Tinkerforge/isolator-bricklet/hardware/isolator.FCStd

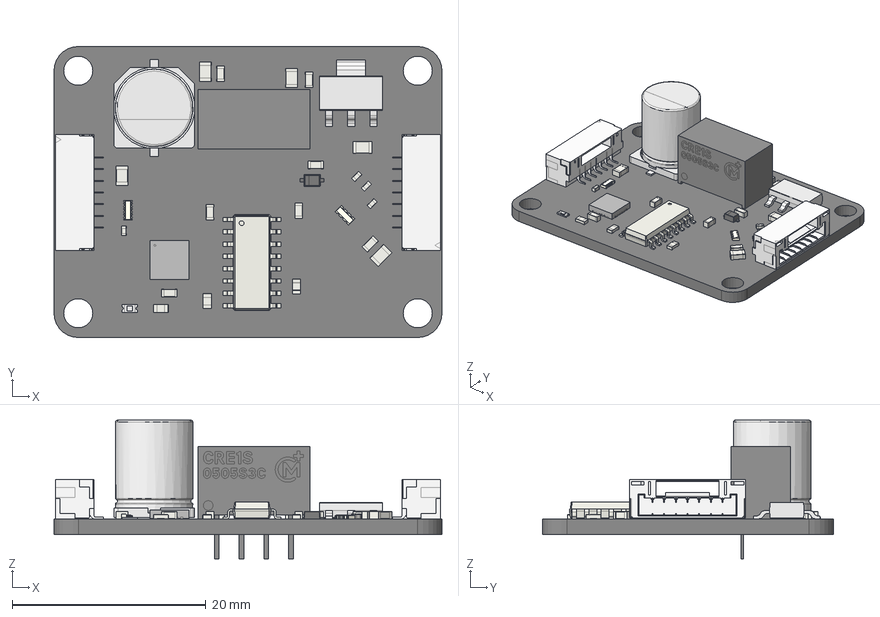
[picture p2: CAD file, 2018-07-31]
hardware/isolator.FCStd
40.0 x 30.0 x 14.3 mm
Pcb
C_0805_
c_elec_8x10_
soic_16_39x99_p127_
C_0805_001
C_0603_
C_0603_001
C_0805_002
C_0603_002
C_0603_003
C_0805_003
C_0603_004
C_0805_004
C_0603_005
C_0603_006
SOD323F_
D_0603_blue_
BrickletConn_7pin_
BrickletConn_7pin_001
R_0603_
R_0603_001
R_0603_002
SOT-223_
QFN-24_4x4mm_Pitch0.5mm_
C_0402_
C_0402_001
C_0402_002
C_0402_003
CRE1S_
