Tinkerforge/isolator-bricklet/hardware/isolator-schematic.pdf

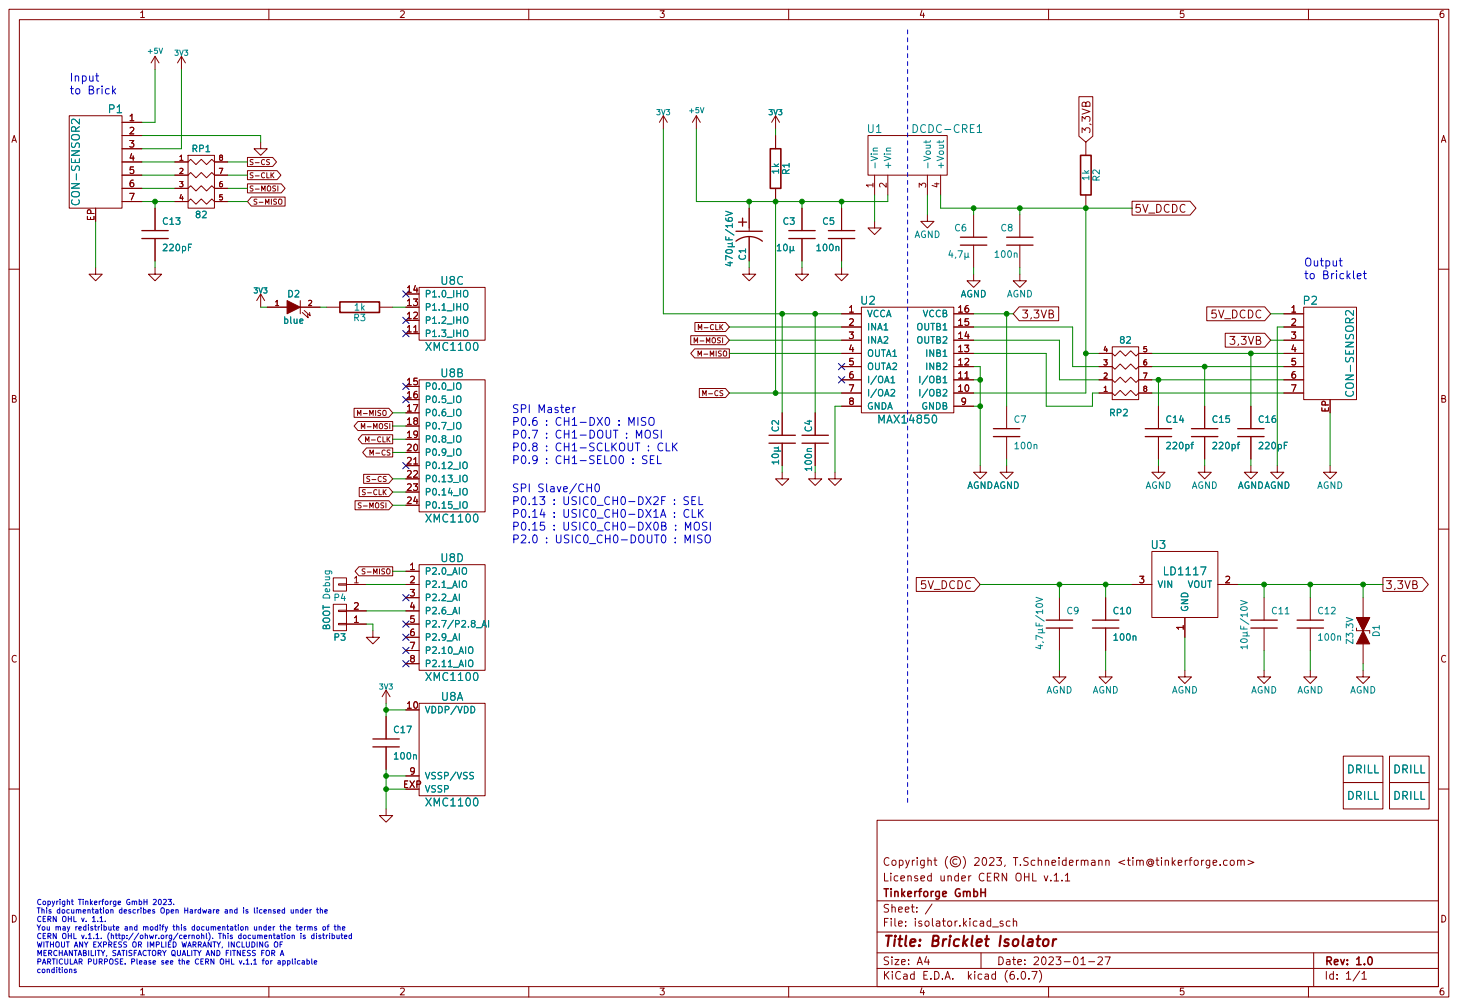
[picture p3: page 1]

to Bricklet SPI Master

Licensed under CERN OHL v.1.1
File: isolator.kicad_sch Sheet: / Tinkerforge GmbH

Copyright Tinkerforge GmbH 2023. This documentation describes Open Hardware and is licensed under the CERN OHL v. 1.1. You may redistribute and modify this documentation under the terms of the CERN OHL v.1.1. (http://ohwr.org/cernohl). This documentation is distributed WITHOUT ANY EXPRESS OR IMPLIED WARRANTY, INCLUDING OF MERCHANTABILITY, SATISFACTORY QUALITY AND FITNESS FOR A

Id: 1/1 Title: Bricklet Isolator

PARTICULAR PURPOSE. Please see the CERN OHL v.1.1 for applicable
