Tinkerforge/isolator-bricklet/software/src/main.c

/* isolator-bricklet
 * Copyright (C) 2018 Olaf Lüke <olaf@tinkerforge.com>
 *
 * main.c: Initialization for Isolator Bricklet
 *
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
 * You should have received a copy of the GNU Lesser General Public
 * License along with this library; if not, write to the
 * Free Software Foundation, Inc., 59 Temple Place - Suite 330,
 * Boston, MA 02111-1307, USA.
 */

#include <stdio.h>
#include <stdbool.h>

#include "configs/config.h"

#include "bricklib2/bootloader/bootloader.h"
#include "bricklib2/hal/system_timer/system_timer.h"
#include "bricklib2/logging/logging.h"
#include "communication.h"
#include "spitfp_master.h"

int main(void) {
	logging_init();
	logd("Start Isolator Bricklet\n\r");

	communication_init();
	spitfp_master_init();

	while(true) {
		bootloader_tick();
		communication_tick();
		spitfp_master_tick();
	}
}
