Tinkerforge/isolator-bricklet/(commit log)

2017-02-10 Add schematics
    [bricklet-isolator.sch]
2017-02-10 Add missing footprint
    [bricklet-isolator.sch]
2017-02-10 add drill holes
    [bricklet-isolator.sch]
2017-02-10 Optical adjustments
    [bricklet-isolator.sch]
2017-02-10 Add PCB
    [bricklet-isolator.kicad_pcb]
2017-02-10 Change diode type to TVS
    [bricklet-isolator.sch]
2017-02-10 Add routing
    [bricklet-isolator.kicad_pcb]
2017-02-13 Fix DCDC footprint
    [bricklet-isolator.kicad_pcb]
2017-02-13 Add PDF schematic
2017-02-14 Add license information
    [bricklet-isolator.sch]
2017-02-23 Fix positions of WEEE and CE logos
    [bricklet-isolator.kicad_pcb]
2017-05-05 Change filtering to R/C circuit
    [bricklet-isolator.kicad_pcb, bricklet-isolator.sch]
2017-05-05 Add schematic PDF
2017-05-05 Add fiducial marks
    [bricklet-isolator.kicad_pcb]
2017-05-08 fix footprints
    [bricklet-isolator.kicad_pcb, bricklet-isolator.sch]
2017-05-08 fix ground plane
    [bricklet-isolator.kicad_pcb]
2017-05-08 add description
    [bricklet-isolator.kicad_pcb]
2017-05-12 Fix CE logo
    [bricklet-isolator.kicad_pcb]
2017-12-11 Add first version with coMCU
    [bricklet-isolator.sch]
2017-12-11 Complete adding coMCU
    [bricklet-isolator.sch]
2017-12-11 PCB: Change layout for coMCU
    [bricklet-isolator.kicad_pcb, bricklet-isolator.sch]
2017-12-11 change uC orientation, bus change, routing not complete
    [bricklet-isolator.kicad_pcb, bricklet-isolator.sch]
2017-12-11 Fix SPI interfaces & complete layout
    [bricklet-isolator.kicad_pcb, bricklet-isolator.sch]
2018-03-16 fix typo
    [bricklet-isolator.kicad_pcb]
2018-05-11 Add auto-generated software stub
    [cmake_config_custom.txt]
2018-05-17 Fix priorities and limits
    [config_custom_bootloader.h, config_spitfp_master.h]
2018-05-17 Update send timer before it is started
2018-06-06 fix logos, fix origin, fix name, add status text
    [bricklet-isolator.kicad_pcb]
2018-06-11 Add 3d information (final)
    [bricklet-isolator.kicad_pcb]
2018-06-18 Remove cache libary
    [bricklet-isolator.sch]
2018-06-27 Make sure that we never read more bytes then currently necessary
2018-07-17 specify processor
    [bricklet-isolator.kicad_pcb, bricklet-isolator.sch]
2018-07-31 Add 3d model (*.FCStd & *.step)
    [bricklet-isolator.FCStd]
2018-07-31 Rename files
    [isolator.FCStd, isolator.kicad_pcb, isolator.sch]
2018-09-10 Add examples
    Mathematica, MATLAB/Octave amd LabVIEW are missing.
    [example_simple.c]
2019-06-13 specify processor, fix references
    [isolator.kicad_pcb, isolator.sch]
2020-08-31 uc: Use fixed-with placeholders in format strings.
    [example_simple.c]
2020-09-02 uc: Add example driver note.
2021-10-25 Update KiCad link
    https://www.kicad.org/blog/2021/10/Avoid-links-to-former-kicad-domain/
2022-04-27 uc: Adapt to bindings changes
    [example_simple.c]
2023-01-27 fix schematic
    [isolator.kicad_sch, isolator.sch]
2023-01-27 Data Cleanup
    [isolator.kicad_pcb, isolator.kicad_sch]
