Tinkerforge/isolator-bricklet/(notices)

Notices in the files:
hardware/isolator.kicad_sch:
Copyright (©) 2023, T.Schneidermann
